egaudin71/ThermometerOledAttiny85/P_20200319_143131.jpg

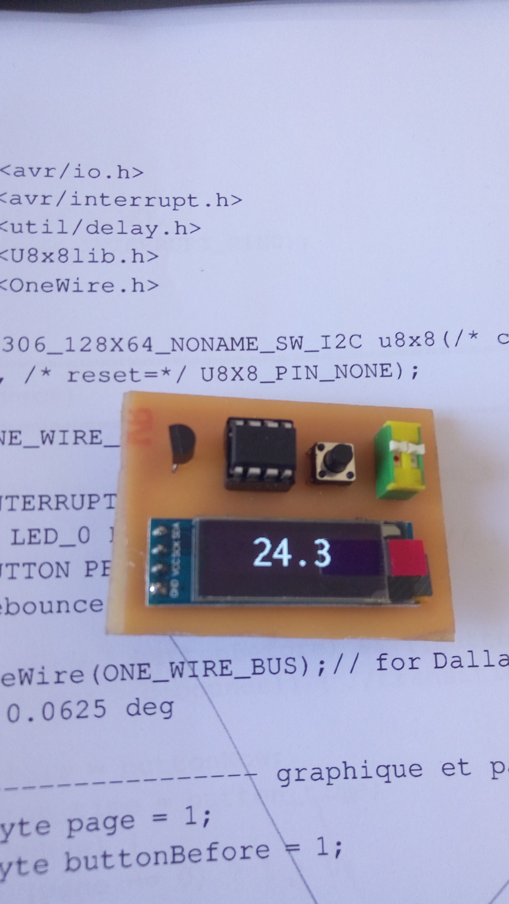
P_20200319_143131.jpg
