egaudin71/ThermometerOledAttiny85/P_20200319_143115.jpg

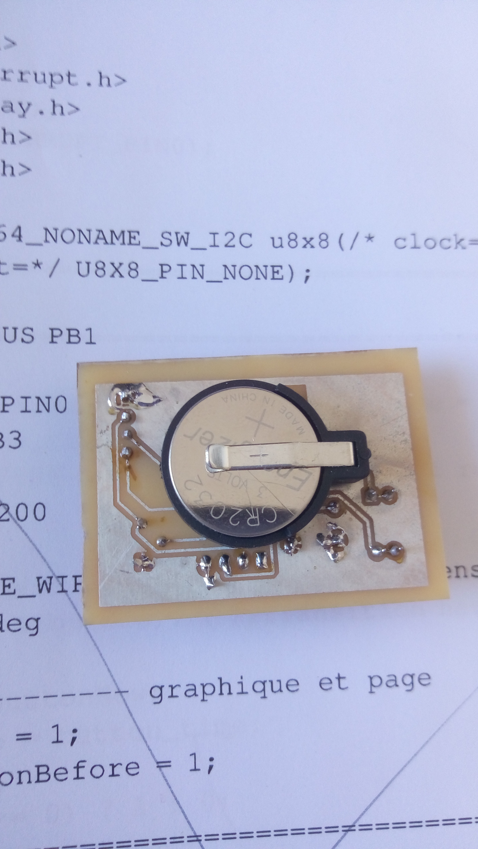
P_20200319_143115.jpg
