egaudin71/ThermometerOledAttiny85/OledDS18B20AttinyCR2032.pdf

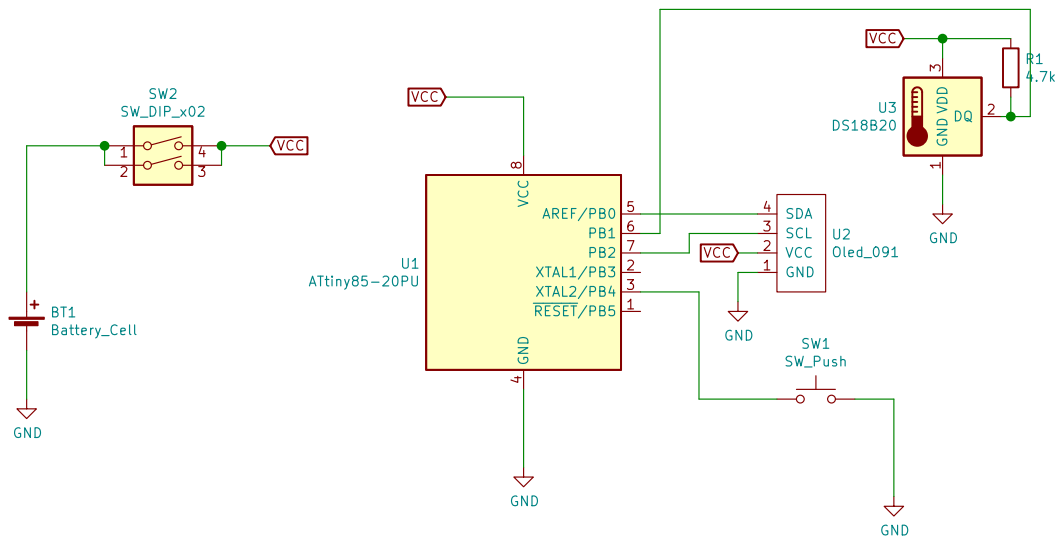
[picture p3: page 1]

8 U1 ATtiny85-20PU GND 1 VCC 2 SCL 3 SDA 4 U2Oled_091 GND GND GND GND
